tecnoplasma/2EZ_WRO_Future_Engineers2024/README.md

# 2EZ
This repository contains a set of work curated by the WRO Future Engineer's finest, Team 2EZ (too easy). 

Members : 
 - Neev Gupta
 - Aryan Shah
 - Divish Bhagtani

# Project/bot description :

Our bot, made of 3D printed shapes from PLA filament, weighs in at around 1.4 kg and is ready to take on the WRO challenge for this year. It consists of 1 pixy camera v2, 3 ultrasonic sensors, one arduino uno rev3, 2 buck converters and other components. The bot has a menacing skull design and is made in bright orange with cyan blue highlights.

# Table of contents :
 - team-photos : which contains 2 photos (1 formal and 1 informal) with every team member
 - bot-photos : which contains 6 photos of the bot (front, back, right, left, top and bottom)
 - diagrams and schemes : which contains schemes and visual representation of the electrical components individually as well as how they interconnect with one an other in the bot
 - Materials and components : contains all of the names and amount of all the components and hardware used to make our bot
 - 3D models : has all the CAD files as well as an animated video of the construction of our bot
 - Reference documents : is filled with written reports/documents/manuals all about our bot and its logistics
 - TeamCode : has all of the code for our bot along with explainations for the code of each round
 - videos : which has a video of our bot in action

# Introduction

Meet our exceptional team of three, ready to take on the World Robot Olympiad (WRO) with our cutting-edge self-automated bot. Driven by creativity and technical expertise, we’ve crafted a machine that embodies innovation and efficiency. Each team member brings a unique set of skills : engineering, programming, and strategy. Allowing us to tackle challenges with precision and teamwork. We’re excited to push the boundaries of robotics and showcase our hard work and passion on this global stage!
