tecnoplasma/2EZ_WRO_Future_Engineers2024/reference documents/2EZ Mobility Management (1).pdf

2EZ

# MOBILITY

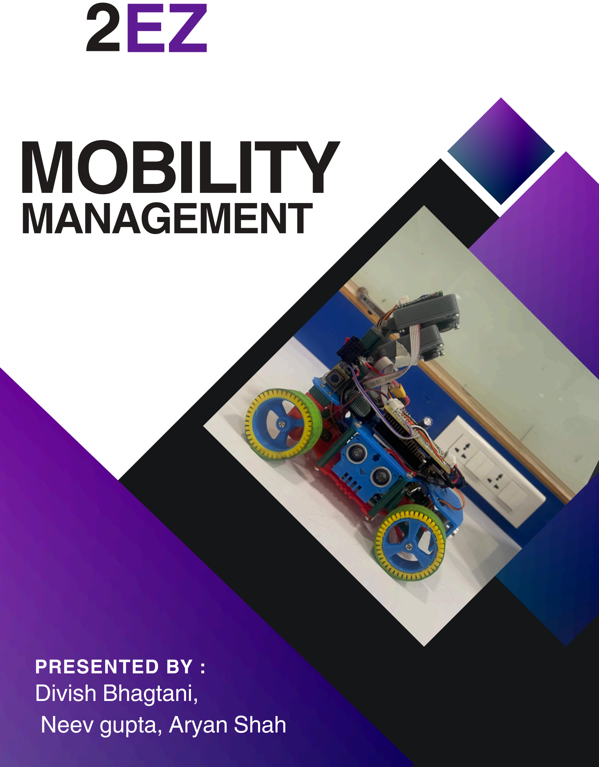
[picture p2: page 1]

# MANAGEMENT

## PRESENTED BY :

Divish Bhagtani,

## Neev gupta, Aryan Shah

1

2

3

# Driving system

# Steering mechanism

# Components used

# Table Of Content

team 2EZ | 02

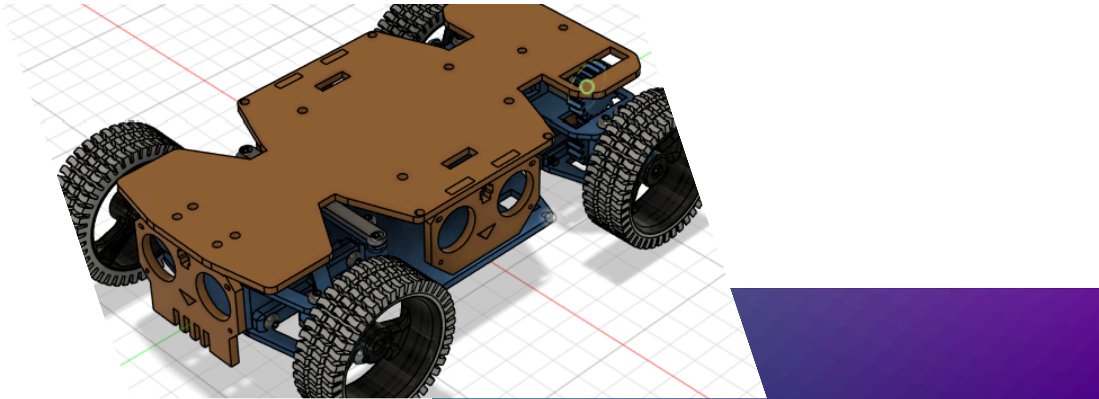
[picture p3: figure]

# Driving system

# 1.1 DC N20 Motor and Single Axle Drive

The DC N20 motor powers both rear wheels through a single axle drive connected by two gears with a 1:1 gear ratio. This means that both rear wheels rotate at the same speed, providing forward and backward movement.
DC N20 Motor Specifications:
Operating voltage: 6V to 12V
No-load speed: 200 RPM
Current draw: 40-70mA at no load, higher under load
Torque: Typically around 0.1-0.2 kg.cm at 6V
The motor is controlled by PWM signals from the Arduino Uno, which adjusts the speed of the rear wheels. The TB6612FNG motor driver manages the power supply and controls motor direction.
How It Works:
Forward movement: The N20 motor drives the rear wheels through the single axle. Both wheels rotate at the same speed, propelling the bot forward.
Backward movement: The motor reverses, causing both rear wheels to rotate in the opposite direction, moving the bot backward.
Since there is no differential, both rear wheels are always locked to rotate at the same speed. This setup provides simple and effective movement, but turning requires more reliance on the front-wheel steering system.

## 1.2 Single Axle and 1:1 Gear Ratio

Purpose: The 1:1 gear ratio ensures both rear wheels rotate at the same speed, which simplifies the drivetrain but makes the bot more reliant on the front-wheel steering for turns.

Team 2EZ | 03

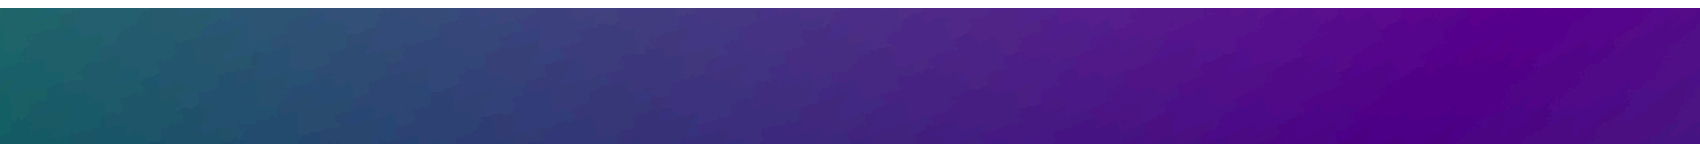
[picture p4: figure]

# Visual depiction

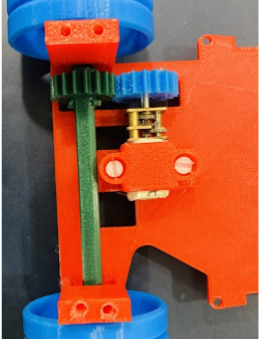
[picture p5: figure]

# Steering system

## 2.1 MG90S Microservo Motor

The steering system is handled by an MG90S microservo motor, which is responsible for controlling the angle of the front two wheels. This servo motor allows the bot to make accurate turns by adjusting the orientation of the front wheels.

MG90S Microservo Specifications:

Operating voltage: 6V
Torque: 2.2 kg.cm at 6V
Speed: 0.08s/60° at 6V
Control: PWM signal from Arduino Uno (generally between 1ms to 2ms pulse width for control angles)

The MG90S microservo is robust, metal-geared, and ideal for handling the steering of the bot’s front wheels. It operates within a range of 0° to 180°, but it typically controls the front wheels within a smaller range to steer the bot left or right.

How It Works:

Left turn: The servo rotates the front wheels to the left, by adjusting the angle to a negative value.
Right turn: The servo rotates the front wheels to the right, using a positive angle.
Straight movement: When the servo is in the neutral (0°) position, the front wheels point straight ahead, allowing the bot to move forward in a straight line.

The Pixy Cam 2 informs the turning direction based on obstacle color detection (green for left, red for right), and the Arduino Uno sends commands to the MG90S servo accordingly.

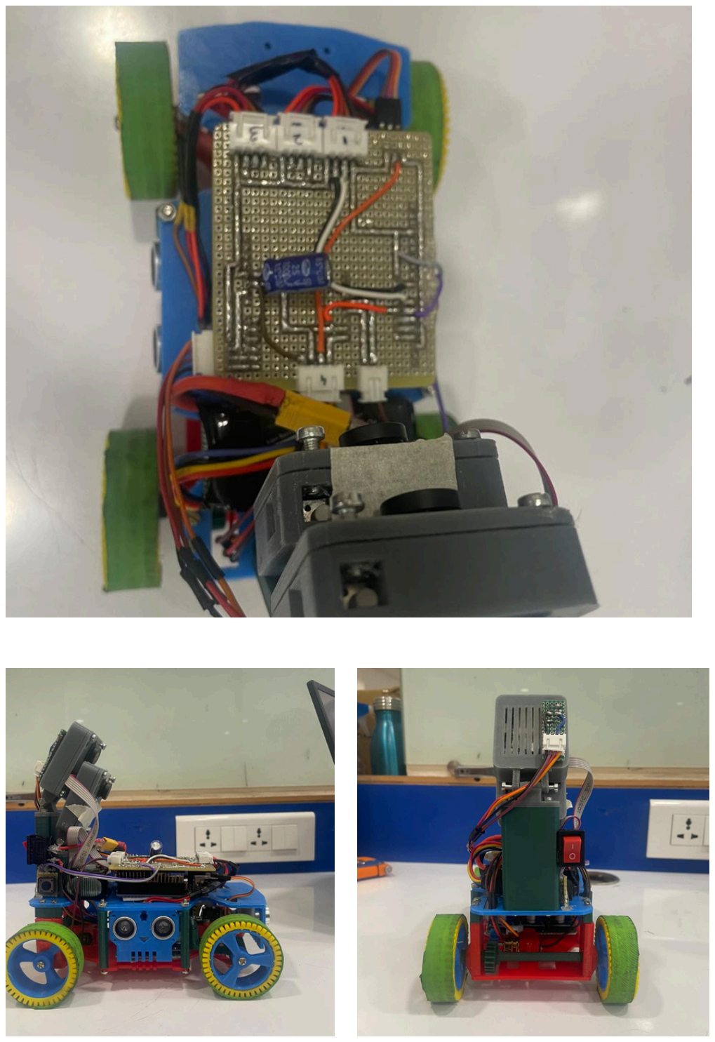
[picture p6: page 6]

# Components

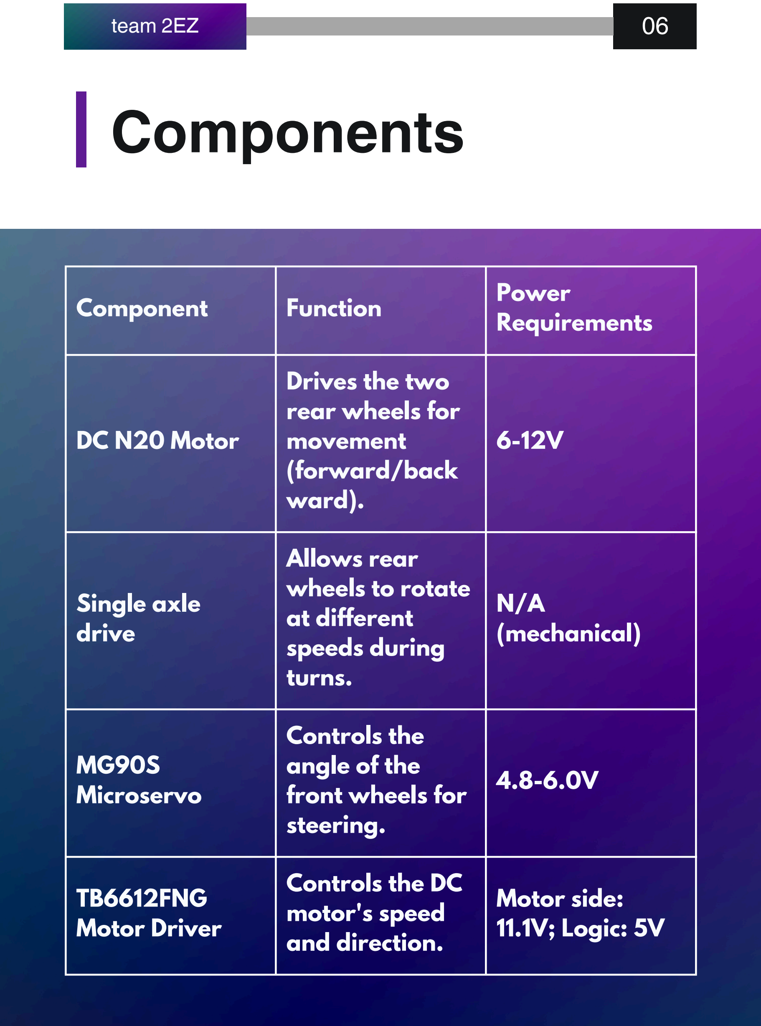
[picture p7: page 7]

Component | Function | Power Requirements
DC N20 Motor | Drives the two rear wheels for movement (forward/back ward). | 6-12V
Single axle drive | Allows rear wheels to rotate at different speeds during turns. | N/A (mechanical)
MG90S Microservo | Controls the angle of the front wheels for steering. | 4.8-6.0V
TB6612FNG Motor Driver | Controls the DC motor's speed and direction. | Motor side: 11.1V; Logic: 5V
team 2EZ | 06
