tecnoplasma/2EZ_WRO_Future_Engineers2024/3D-models/Screenshot 2024-11-25 165132.png

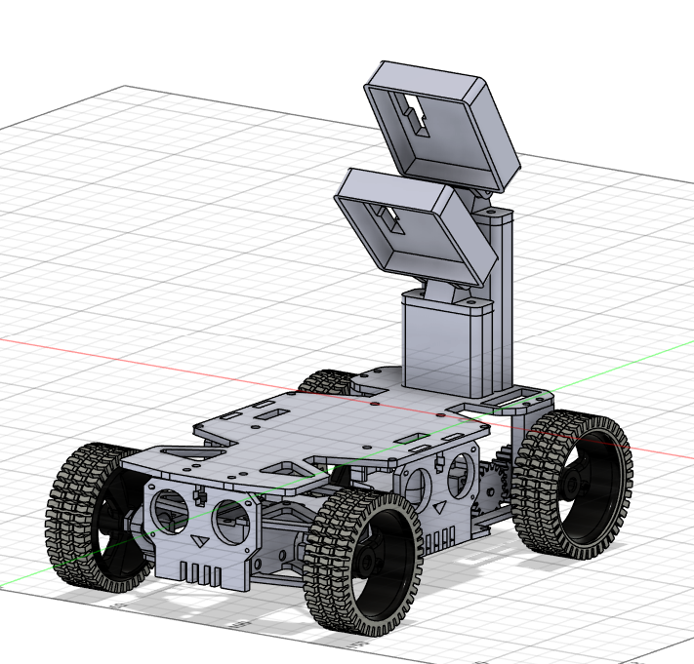
3D-models/Screenshot 2024-11-25 165132.png
