tecnoplasma/2EZ_WRO_Future_Engineers2024/bot-photos/IMG-20241125-WA0013.jpg

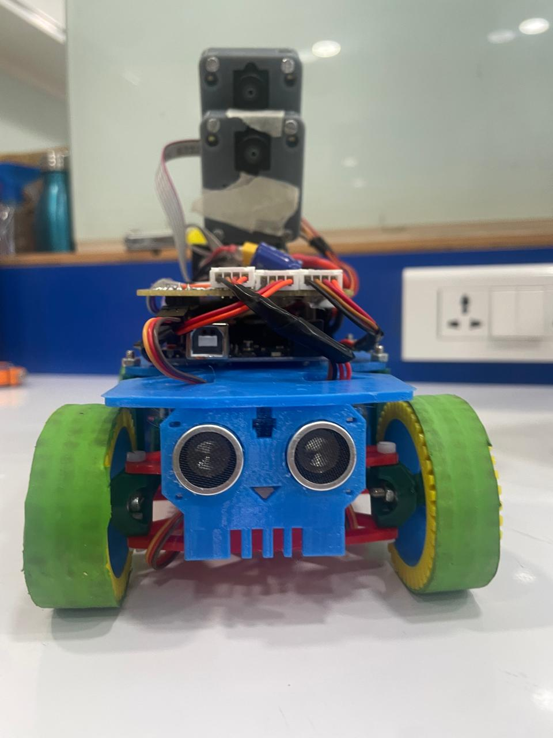
bot-photos/IMG-20241125-WA0013.jpg
