tecnoplasma/2EZ_WRO_Future_Engineers2024/team-photos/IMG_6683.jpeg

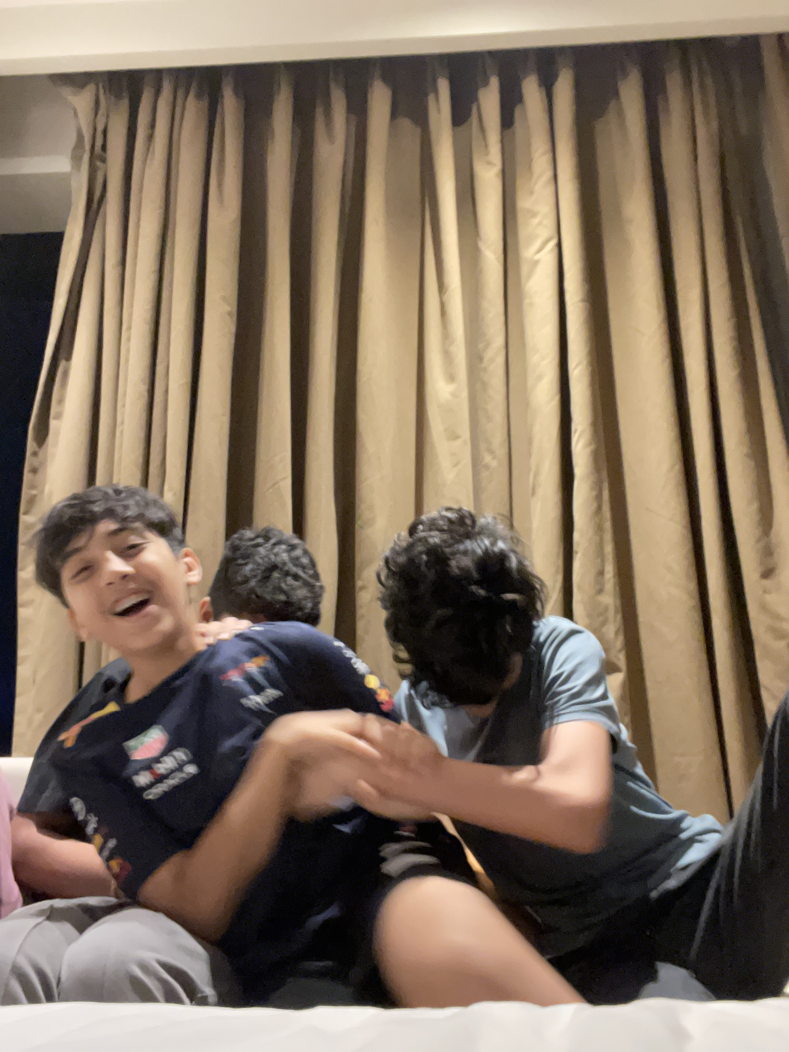
team-photos/IMG_6683.jpeg
