tecnoplasma/2EZ_WRO_Future_Engineers2024/Materials-and-components./Electrical-components/README.md

| Amount | Product | photo |
| --- | --- | --- |
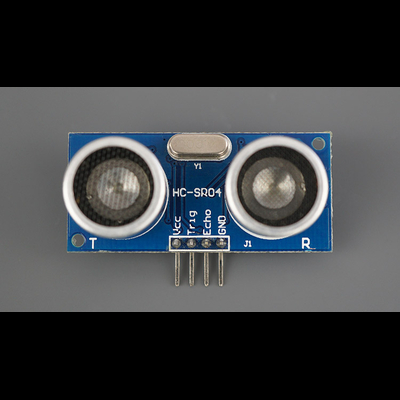
[picture p29: HC-SR04-Ultrasonic-Sensor-Module-Distance-Measurement-Component-Part-Front.jpg]
| 3 | ultrasonic sensor HCSR04 |  |
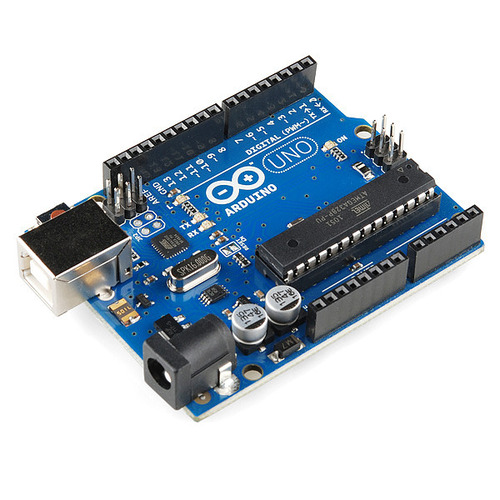
[picture p30: arduino-uno-r3.jpg]
| 1 | Arduino Uno Rev 3 |  |
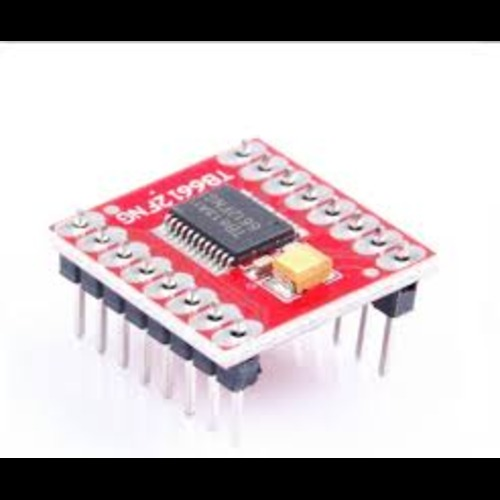
[picture p31: download.jpg]
| 1 | motor driver tb6612fng |  |
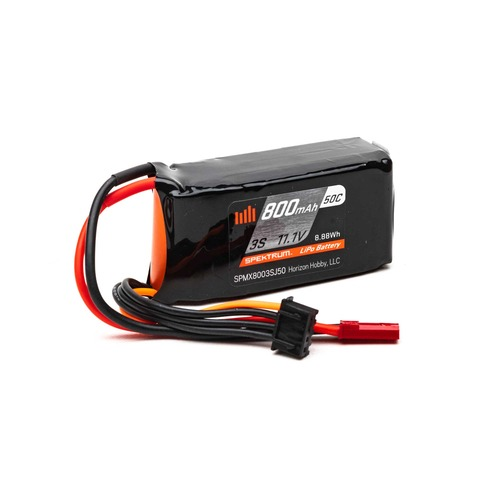
[picture p32: SPMX8003SJ50_A0_TB42ZUIQ.jpg]
| 1 | 3s 11.1v lipo battery |  |
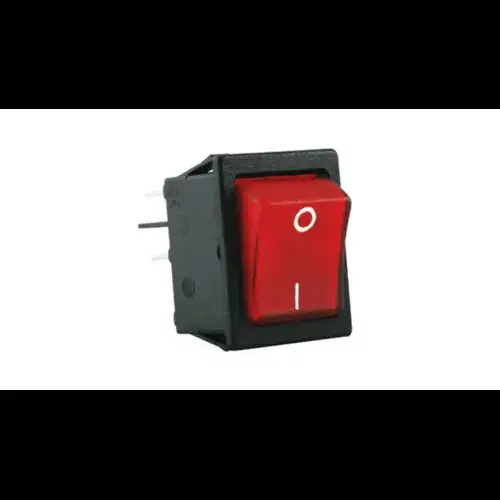
[picture p33: Rocker-Switches.jpg]
| 1 | electrical switch |  |
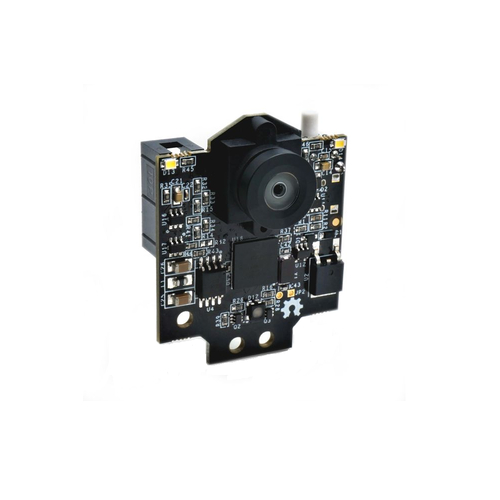
[picture p34: Pixy-2.jpg]
| 2 | Pixy 2 camera |  |
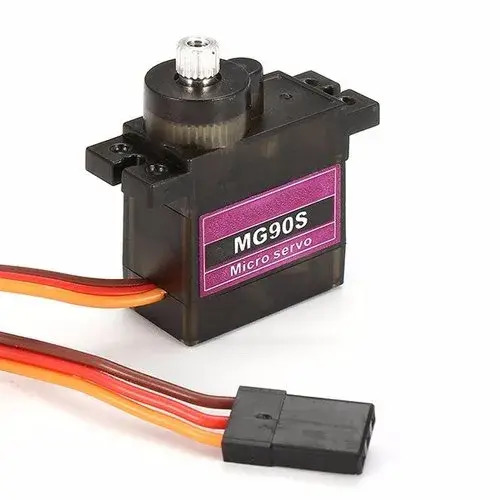
[picture p35: mg90s-mini-metal-geared-micro-servo-motor-500x500.jpg]
| 1 | servo motor mg90s |  |
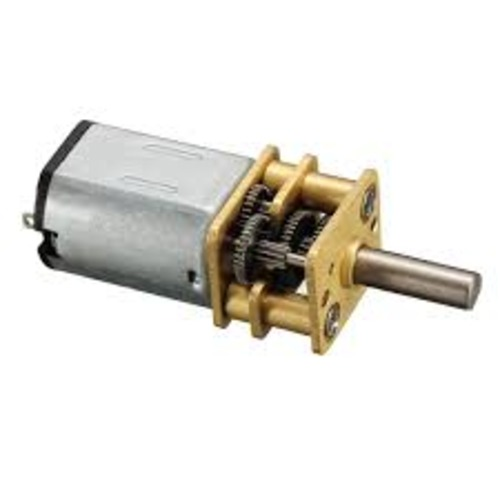
[picture p36: download (1).jpg]
| 1 | dc motor n20 |  |
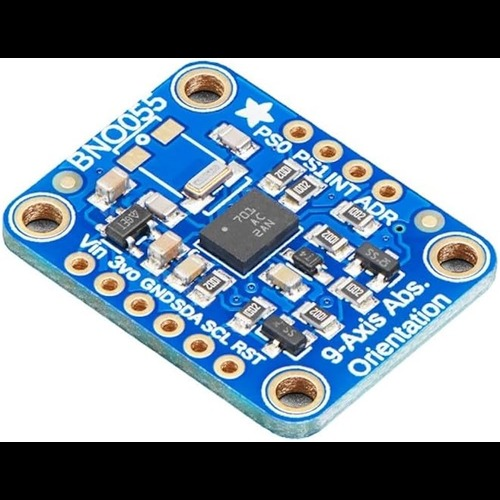
[picture p37: 51qEXrfKgTL._AC_UF1000,1000_QL80_.jpg]
| 1 | IMU BNO055 |  |
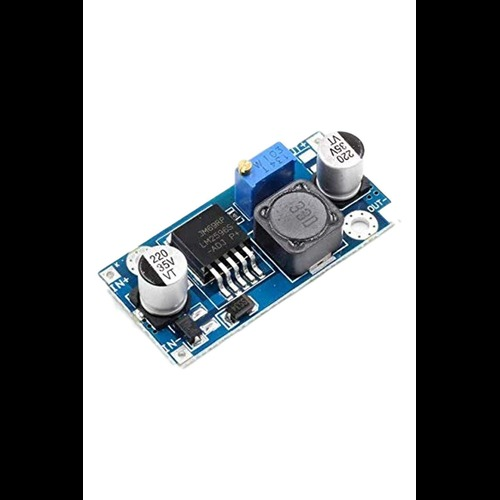
[picture p38: 61Rn2dXAoWL.jpg]
| 3 | lm2596 buck converter |  |
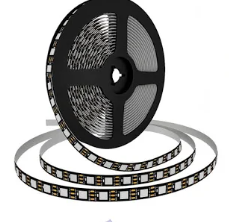
[picture p39: Screenshot 2024-10-04 183006.png]
| 9 | Neo Pixel lights |  |
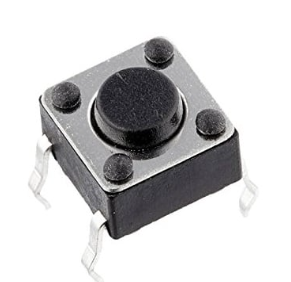
[picture p40: Screenshot 2024-10-04 183148.png]
| 1 | push button |  |
