tecnoplasma/2EZ_WRO_Future_Engineers2024/Materials-and-components./Hardware materials/README.md

# Hardware Materials

| Amount | Material | Photo|
| --- | --- | --- |
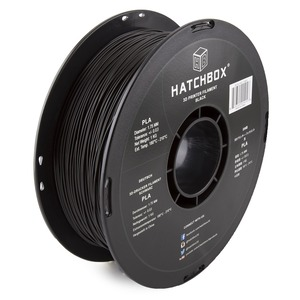
[picture p41: 71ZgqHSYaFL.jpg]
|  | PLA filament |  |
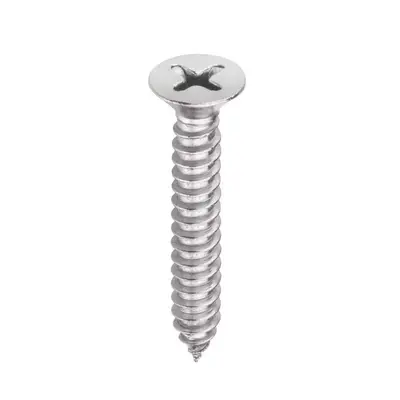
[picture p42: CSK-Phillips-Screw-304-Grade.webp]
| 16 | Screws |  | 
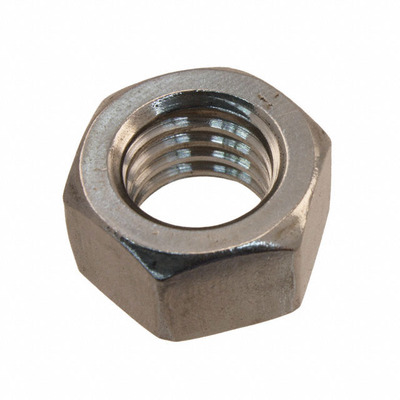
[picture p43: HNSS-025-20.jpg]
| 16 | nuts |  |
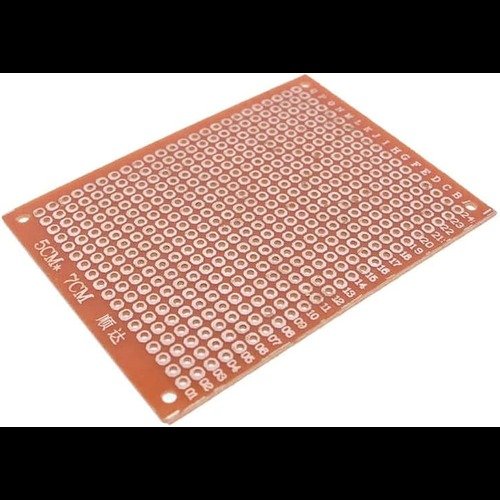
[picture p44: 51I5pZPLTPL._AC_UF1000,1000_QL80_.jpg]
icon
| 1 | Printed circuit board (PCB) |  |

# Tools used to make the bot

 - soldering iron
 - cutter
 - power supply
 - glue gun
 - multimeter
 - drill
 - 3D printer
