tecnoplasma/2EZ_WRO_Future_Engineers2024/(commit log)

2024-08-07 Bug fixes for errors w read
    [2EZCode.ino]
2024-09-18 Create Materials and components
2024-09-18 Update Materials and components
2024-09-18 Create Hardware materials
2024-09-18 Create electrical circuit diagram
2024-09-18 Create chassis diagram
2024-11-17 EVERYTHING WORKS SO WELL. now we need pixy parking
    BRO EVERYTHING IS AMZING. ALL 3 ROUNDS. UTURN AND EVEN ULTRASONIC PARKING!! but ultra parking is kinda bad because it needs to be perfectly lined up. we're gonna put pixy tmrw and im gonna use proportional for turning distance while parking. its abt to be crazyyyyy lets go. things r finally looking up.
2024-11-19 double pixyim so smart im ona different wavelength
    I2C AND SPI IM SONGOIBJKDSVNJKL
2024-11-20 double pixy but its not working, checking changes
    [2EZRoundTwo.ino]
2024-11-22 added park w 2nd pixy but doesnt work
    also last commit, i was saying second pixy dint work. it was coz i forgot to switch it to I2C. so we goooooood
2024-11-24 round two works. pixy problems now
    [2EZRoundTwo.ino]
2024-11-28 at comp but why is it starting wrong
    [2EZRoundTwo.ino]
2024-11-28 reduced threshold but was prolly mech. fixed
    [2EZRoundTwo.ino]
